acidbourbon/8bitrandom/schematic.png

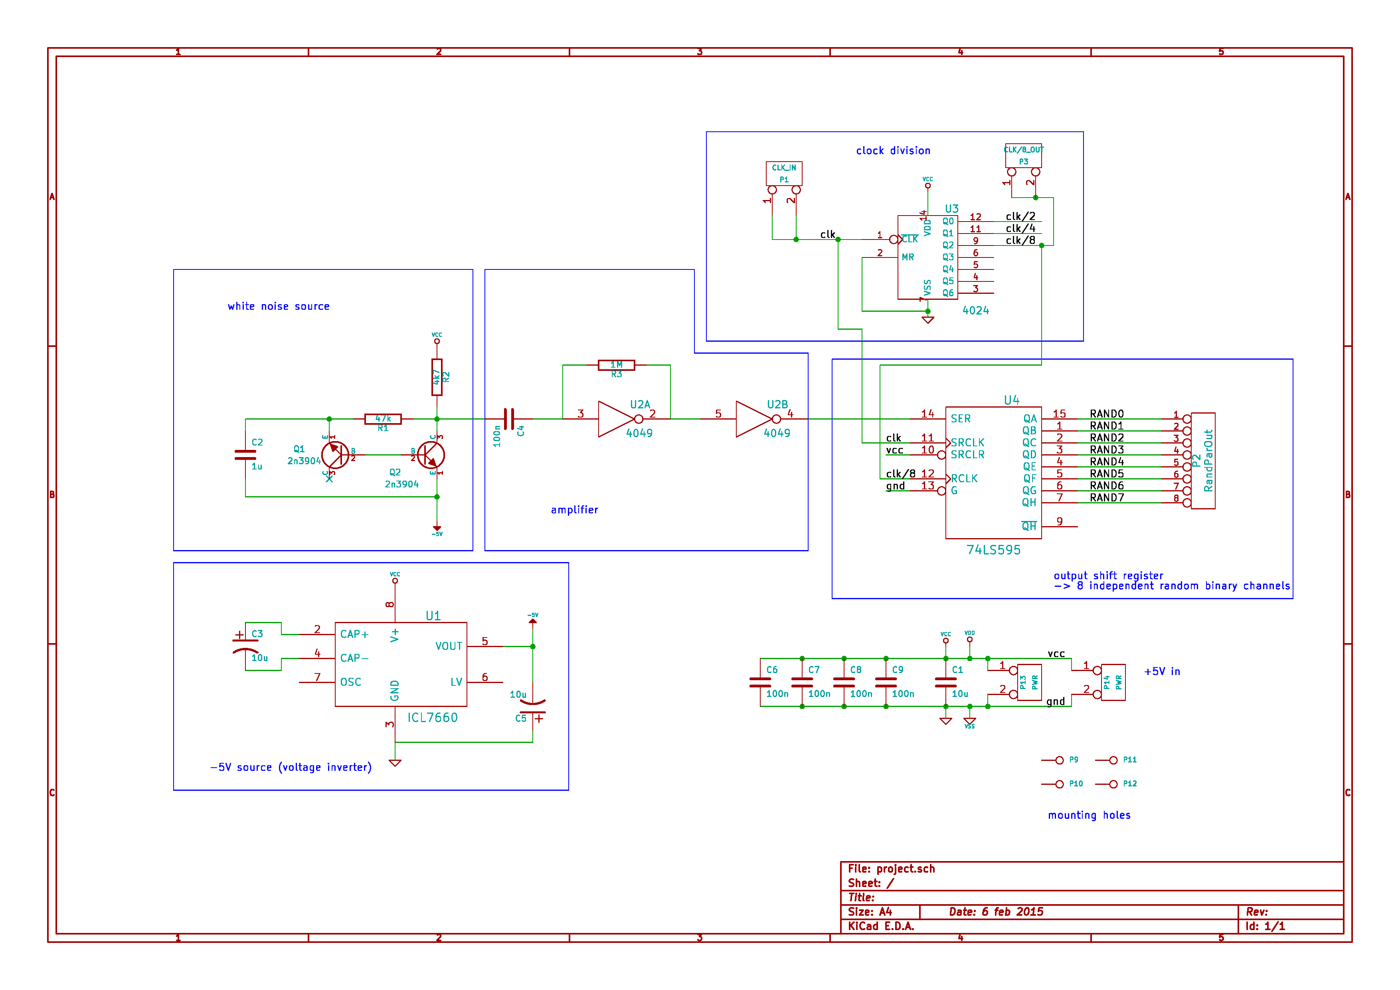
schematic.png
