acidbourbon/8bitrandom/assembly+pinout.pdf

## gnd vcc = 5V

# 8 bit random pattern generator

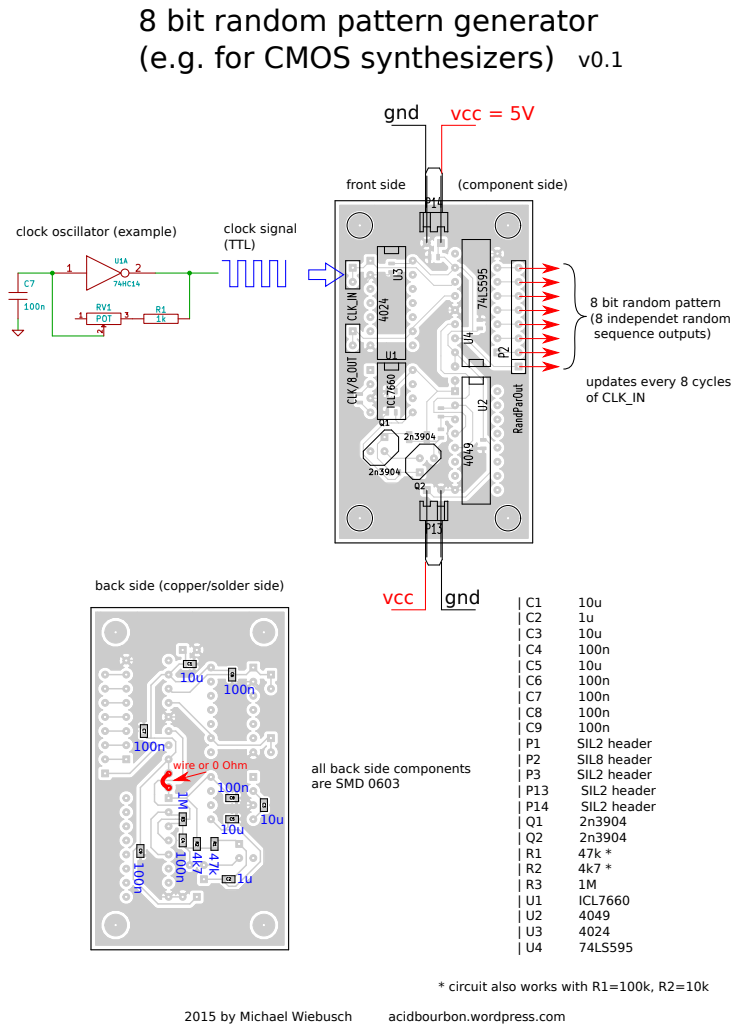
[picture p2: page 1]

back side (copper/solder side)

all back side components
are SMD 0603

* circuit also works with R1=100k, R2=10k
