acidbourbon/8bitrandom/schematic.pdf

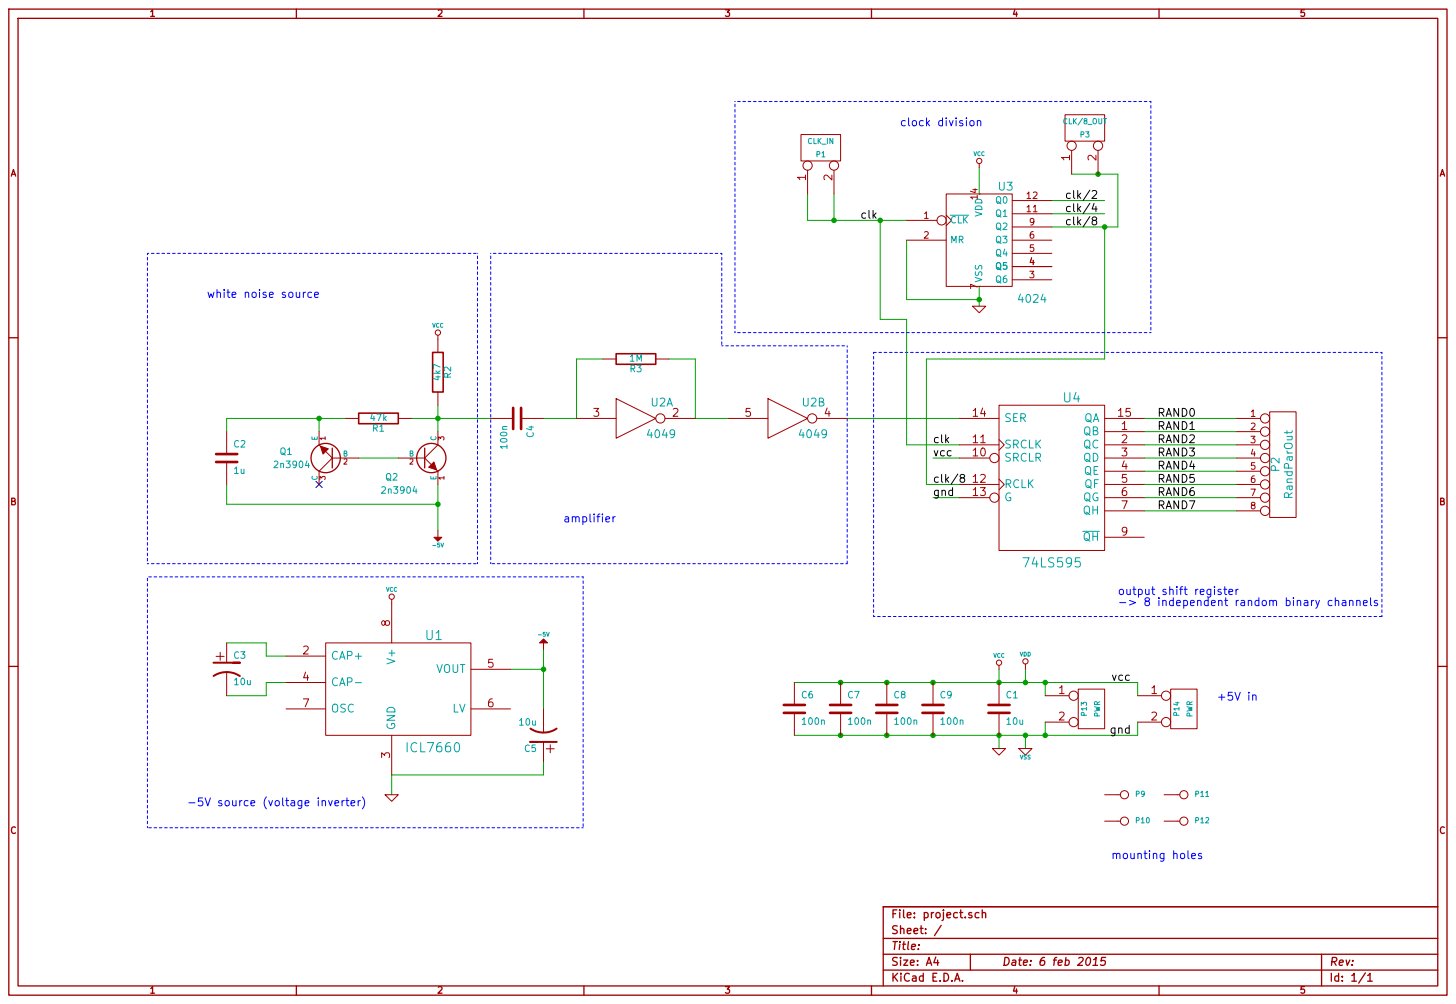
[picture p3: page 1]

-5V source (voltage inverter) white noise source

-> 8 independent random binary channels +5V in mounting holes

Id: 1/1 Title: File: project.sch
Sheet: /
