acidbourbon/8bitrandom/toner_transfer.pdf

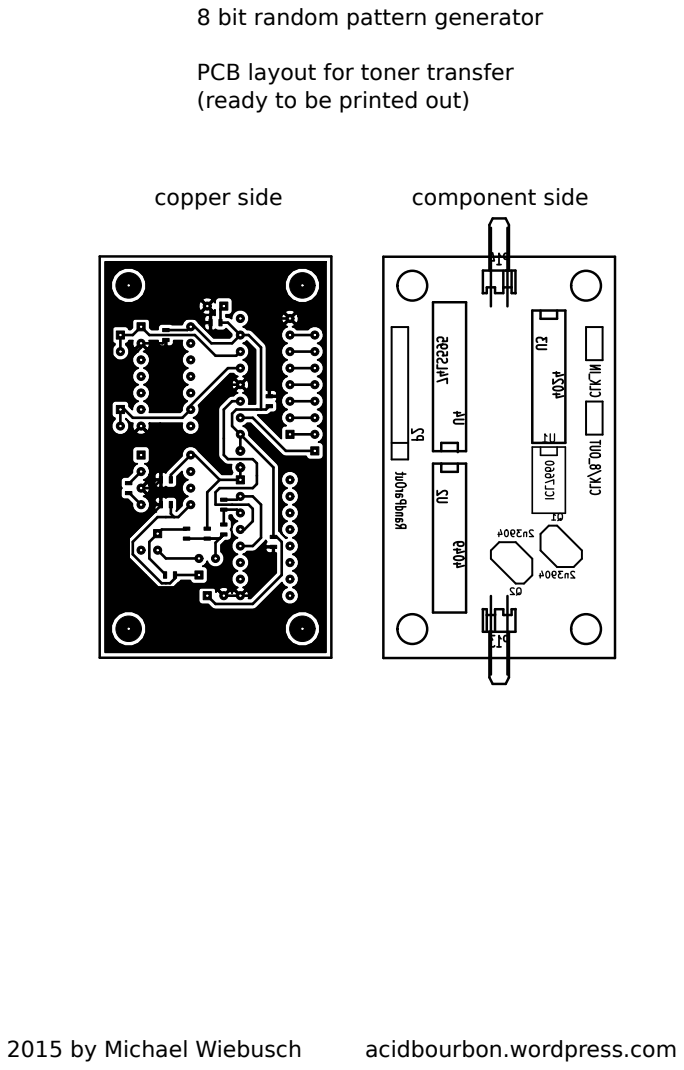
[picture p4: page 1]
copper side; component side; 2015 by Michael Wiebusch; acidbourbon.wordpress.com

8 bit random pattern generator

PCB layout for toner transfer
(ready to be printed out)
