acidbourbon/8bitrandom/(commit log)

2014-02-22 better labels
    [project.brd]
2015-02-07 created assembly+pinout instructions and printable toner transfer page
    [project.brd, project.sch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]
